nlbutts/POVDisplay/Mechanical/POVBaseDriver.FCStd

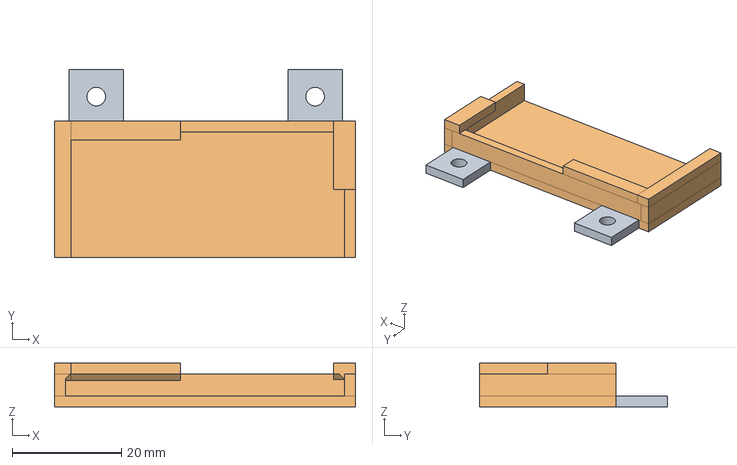
[picture p1: CAD file, 2018-04-08]
Mechanical/POVBaseDriver.FCStd
55.0 x 34.4 x 8.00 mm
