nlbutts/POVDisplay/Mechanical/PCBMotorMount.FCStd

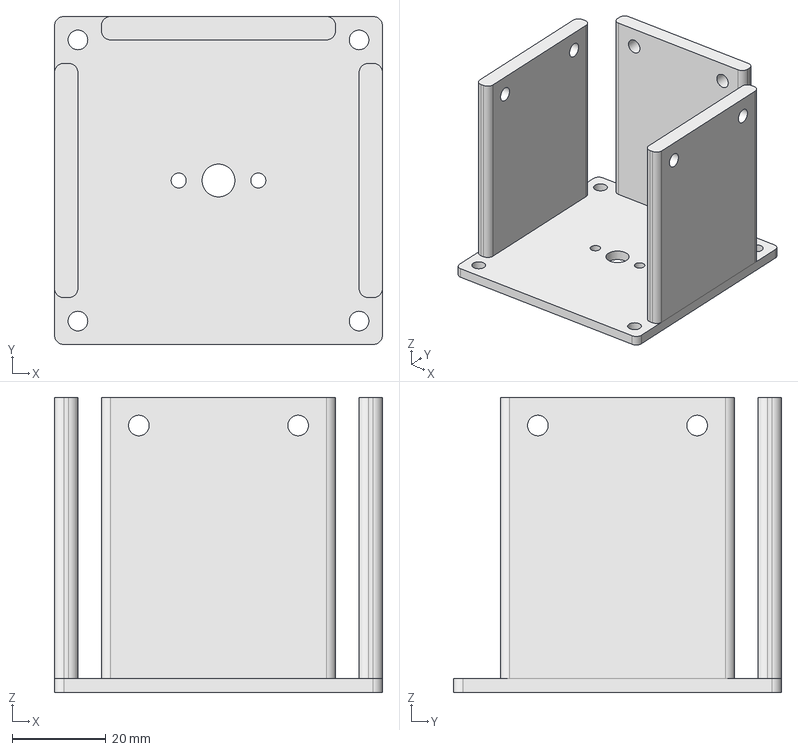
[picture p2: CAD file, 2018-04-08]
Mechanical/PCBMotorMount.FCStd
70.0 x 70.0 x 63.0 mm
