nlbutts/POVDisplay/Mechanical/BalanceSlider.FCStd

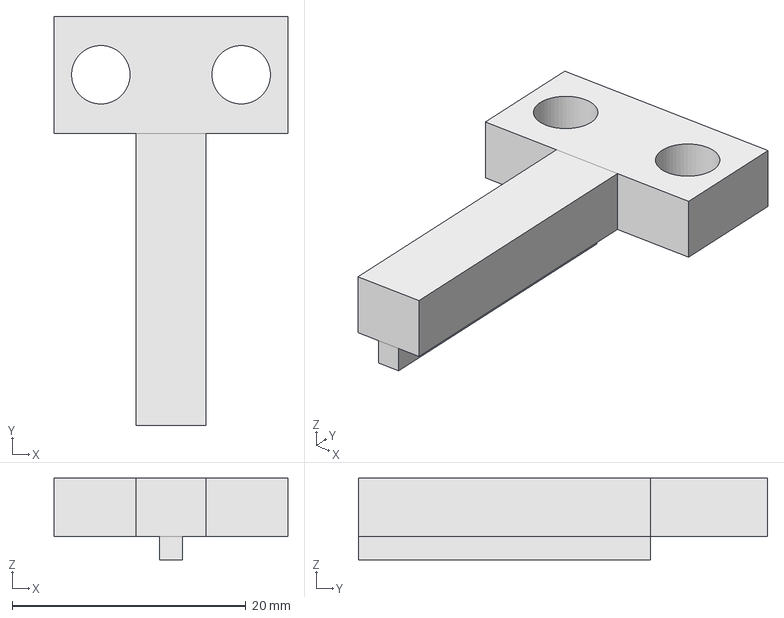
[picture p3: CAD file, 2018-04-08]
Mechanical/BalanceSlider.FCStd
20.0 x 35.0 x 7.00 mm
