nlbutts/POVDisplay/Mechanical/motor_adapter.FCStd

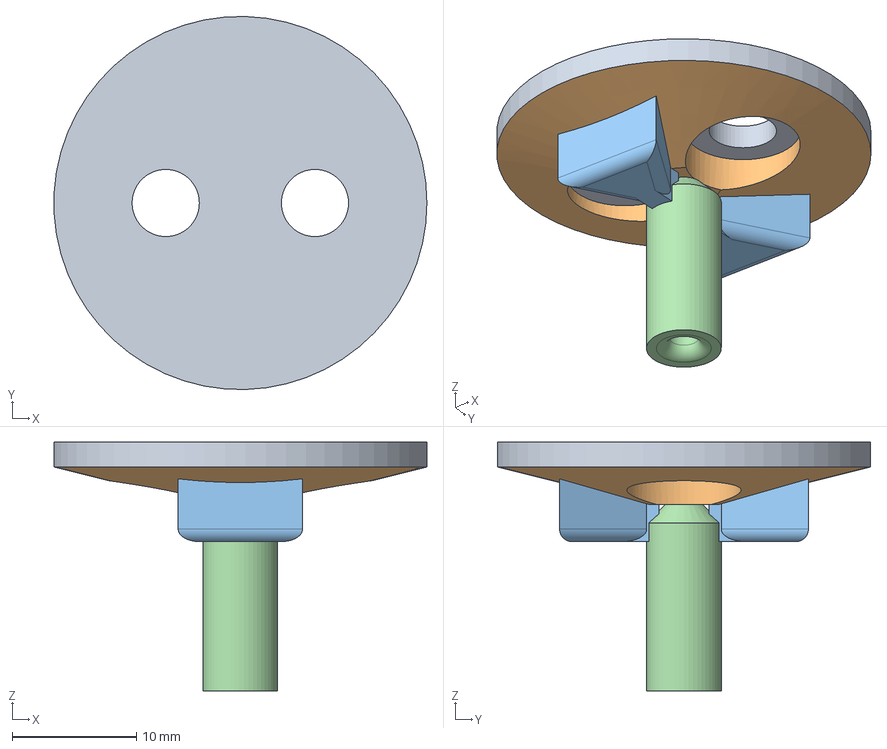
[picture p4: CAD file, 2018-04-08]
Mechanical/motor_adapter.FCStd
30.0 x 30.0 x 20.0 mm
PCBMount
