nlbutts/POVDisplay/Mechanical/WoodMounts.FCStd

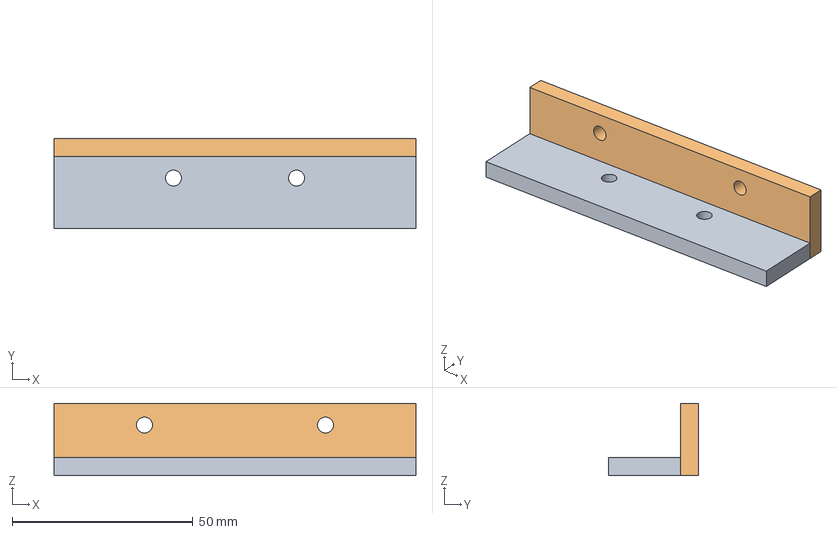
[picture p5: CAD file, 2018-04-08]
Mechanical/WoodMounts.FCStd
100.0 x 25.0 x 20.0 mm
