nlbutts/POVDisplay/Mechanical/PCBMount.FCStd

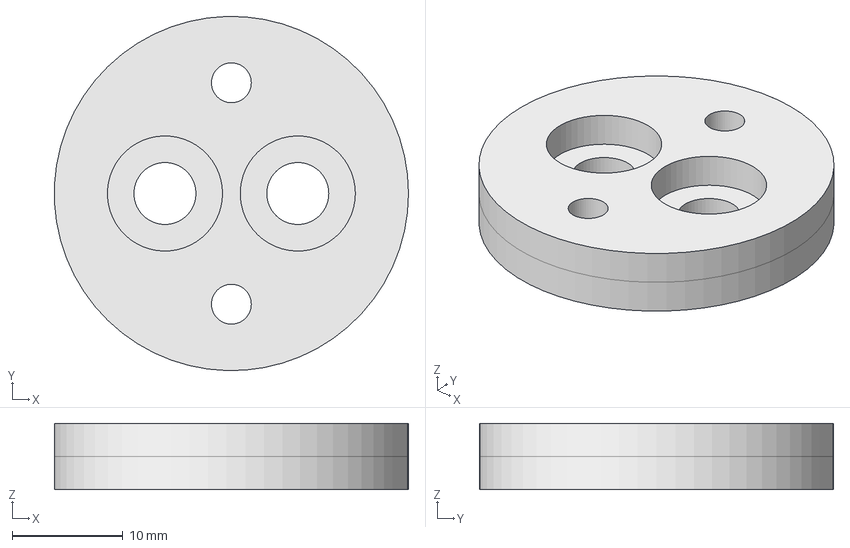
[picture p6: CAD file, 2018-04-08]
Mechanical/PCBMount.FCStd
32.0 x 32.0 x 6.00 mm
