nlbutts/POVDisplay/Mechanical/BalanceWeight.FCStd

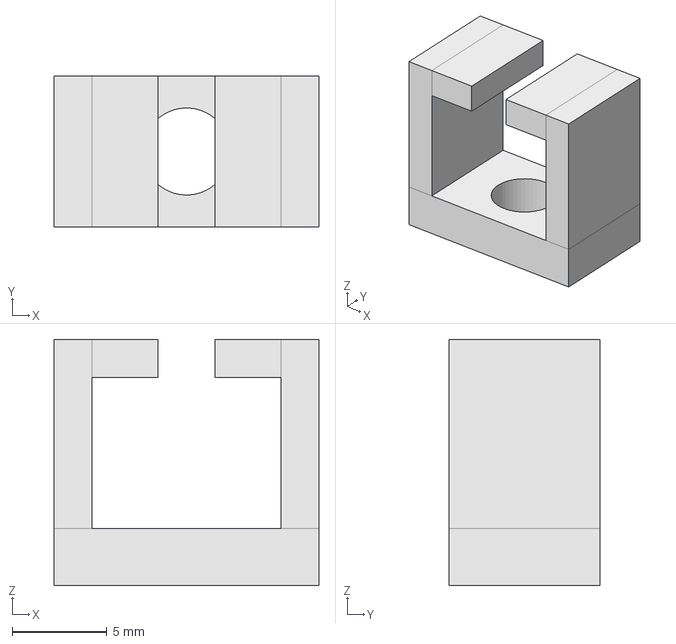
[picture p7: CAD file, 2018-04-08]
Mechanical/BalanceWeight.FCStd
14.0 x 8.00 x 13.0 mm
