nlbutts/POVDisplay/Mechanical/POVDisplay.FCStd

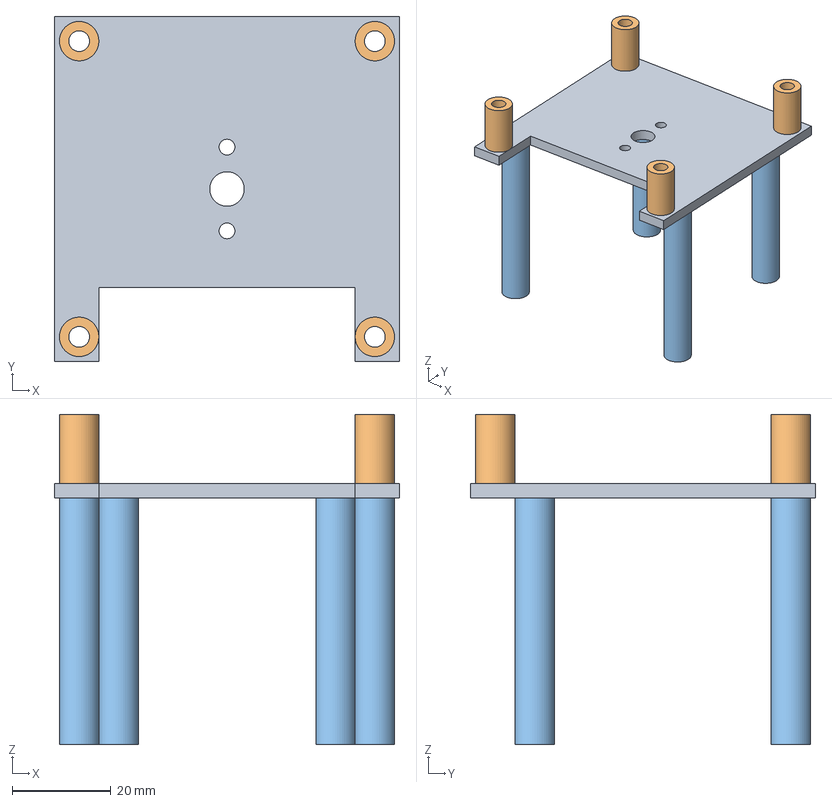
[picture p8: CAD file, 2018-04-08]
Mechanical/POVDisplay.FCStd
70.0 x 70.0 x 67.0 mm
