nlbutts/POVDisplay/Mechanical/TopMotorMount.FCStd

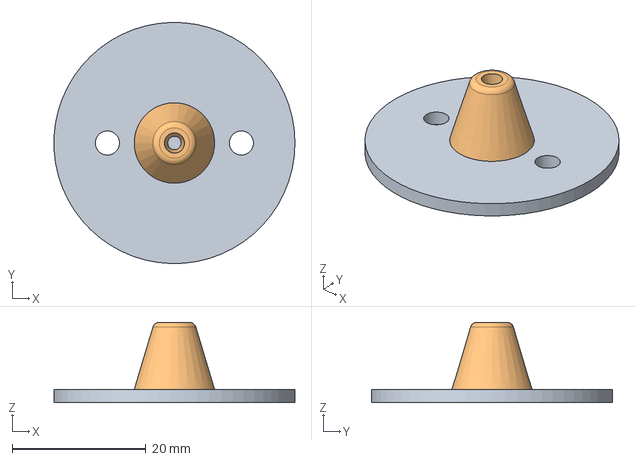
[picture p9: CAD file, 2018-04-08]
Mechanical/TopMotorMount.FCStd
36.0 x 36.0 x 12.0 mm
