nlbutts/POVDisplay/POVRotateHW/POVRotateHW.kicad_pcb

## KiCad design POVRotateHW/POVRotateHW.kicad_pcb (2018-04-08)

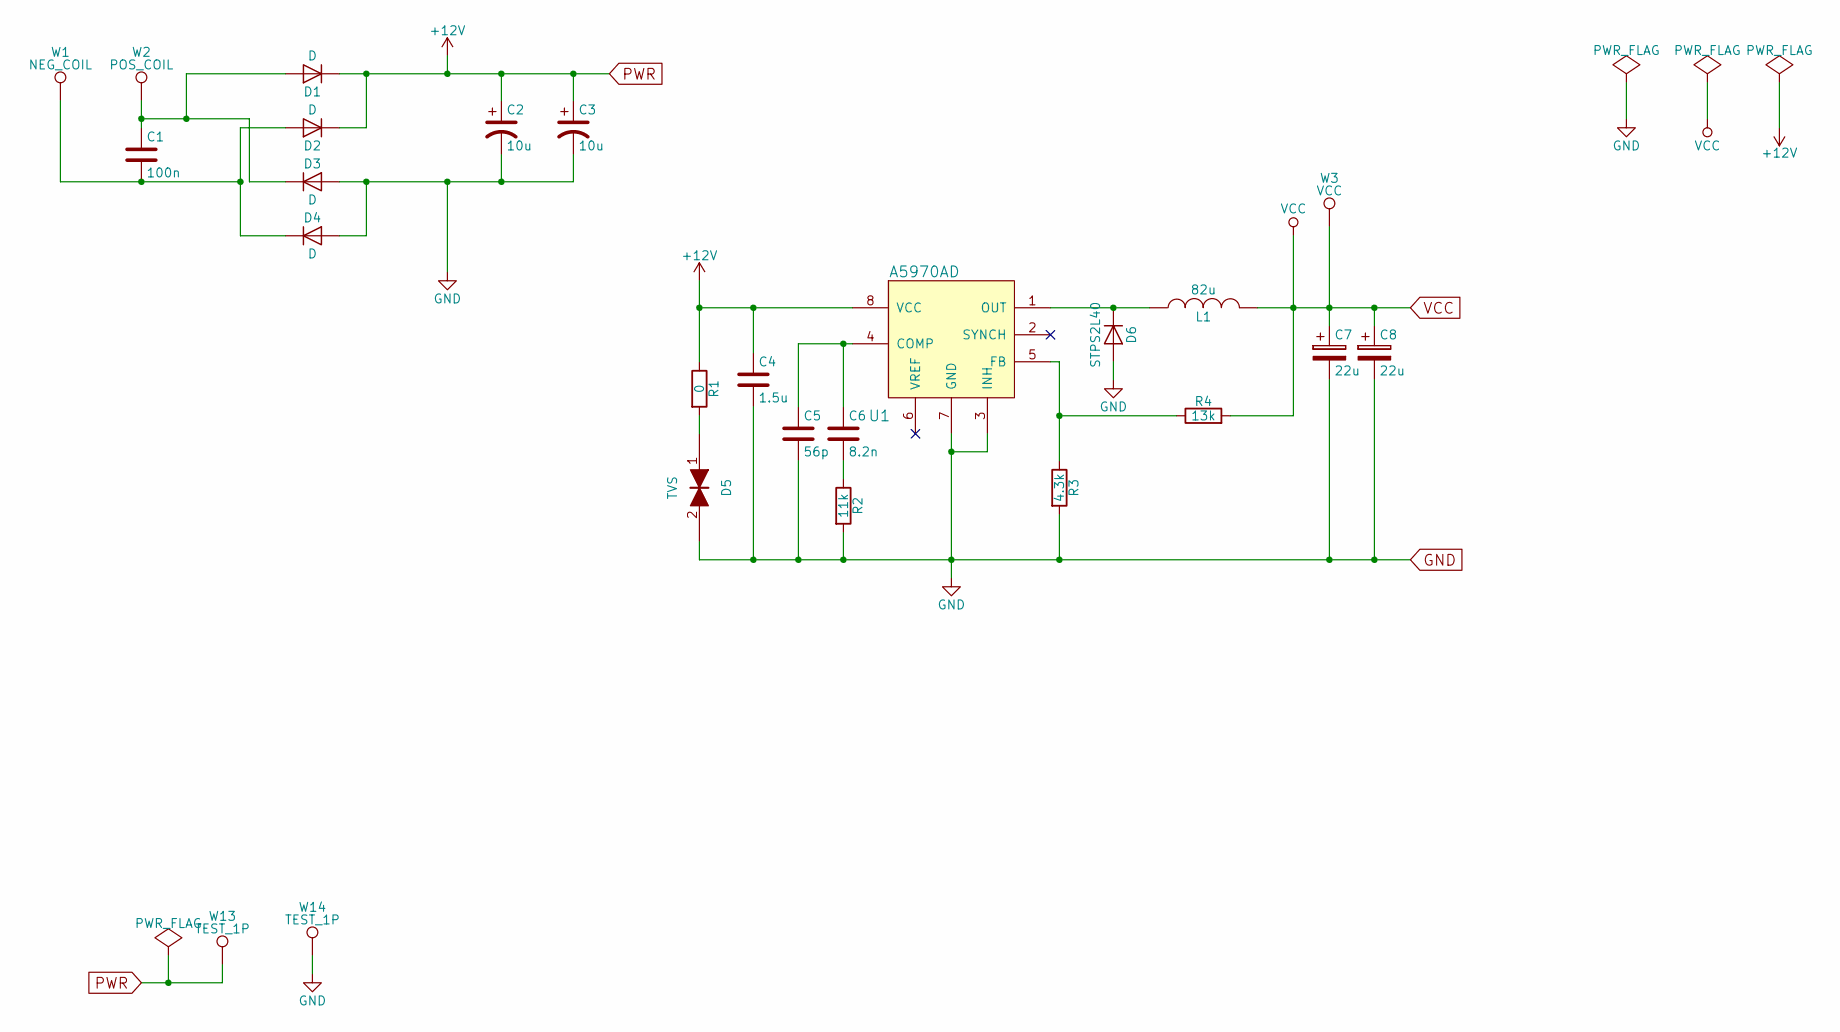
[picture p10: schematic Power.sch, POV Base Controller]

Parts:
C1: 100n; C_1210_HandSoldering
C2, C3: 10u; c_elec_5x5.8; PartNum EEE-FT1H220AR; DIGIKEY PCE5022CT-ND
C4: 1.5u; C_0805_HandSoldering; DIGIKEY 445-12701-1-ND
C5: 56p; C_0603_HandSoldering
C6: 8.2n; C_0603_HandSoldering
C7, C8: 22u; SMD-1210_Pol; PartNum TPSB226K006R0375; DIGIKEY 478-9063-1-ND
D1, D2, D3, D4: D; SMB_Handsoldering; PartNum STPS2L40U; DIGIKEY 497-5574-1-ND
D5: TVS; SMB_Handsoldering; PartNum 824520201; DIGIKEY 732-9779-1-ND
D6: STPS2L40; SMB_Handsoldering; PartNum STPS2L40U; DIGIKEY 497-5574-1-ND
L1: 82u; TDK_inductor_12.95x9.4x8.08; PartNum B82476A1104M; Digikey 495-2686-1-ND
R1: 0; R_0603_HandSoldering
R2: 11k; R_0603_HandSoldering
R3: 4.3k; R_0603_HandSoldering
R4: 13k; R_0603_HandSoldering
U1: A5970AD; SOIC-8-N; PartNum A5970ADTR; DIGIKEY 497-10183-1-ND
W1: NEG_COIL; MountingHole_3.2mm_M3_DIN965_Pad
W2: POS_COIL; MountingHole_3.2mm_M3_DIN965_Pad
W3: VCC; Measurement_Point_Round-SMD-Pad_Small
W13, W14: TEST_1P; Measurement_Point_Round-SMD-Pad_Small

Connections:
GND: C2.2, C3.2, C4.2, C5.2, C7.2, C8.2, D3.2 (A), D4.2 (A), D5.2, D6.2 (A), R2.2, R3.2, U1.3 (INH), U1.7 (GND), W14.1; also elsewhere on the board
unnamed: C1.1, D1.2 (A), D3.1 (K), W2.1
unnamed: C1.2, D2.2 (A), D4.1 (K), W1.1
unnamed: C5.1, C6.1, U1.4 (COMP)
unnamed: C6.2, R2.1
unnamed: D5.1, R1.2
unnamed: D6.1 (K), L1.1, U1.1 (OUT)
unnamed: R3.1, R4.1, U1.5 (FB)
PWR: C2.1, C3.1, C4.1, D1.1 (K), D2.1 (K), R1.1, U1.8 (VCC), W13.1; also elsewhere on the board
VCC: C7.1, C8.1, L1.2, R4.2, W3.1; also elsewhere on the board

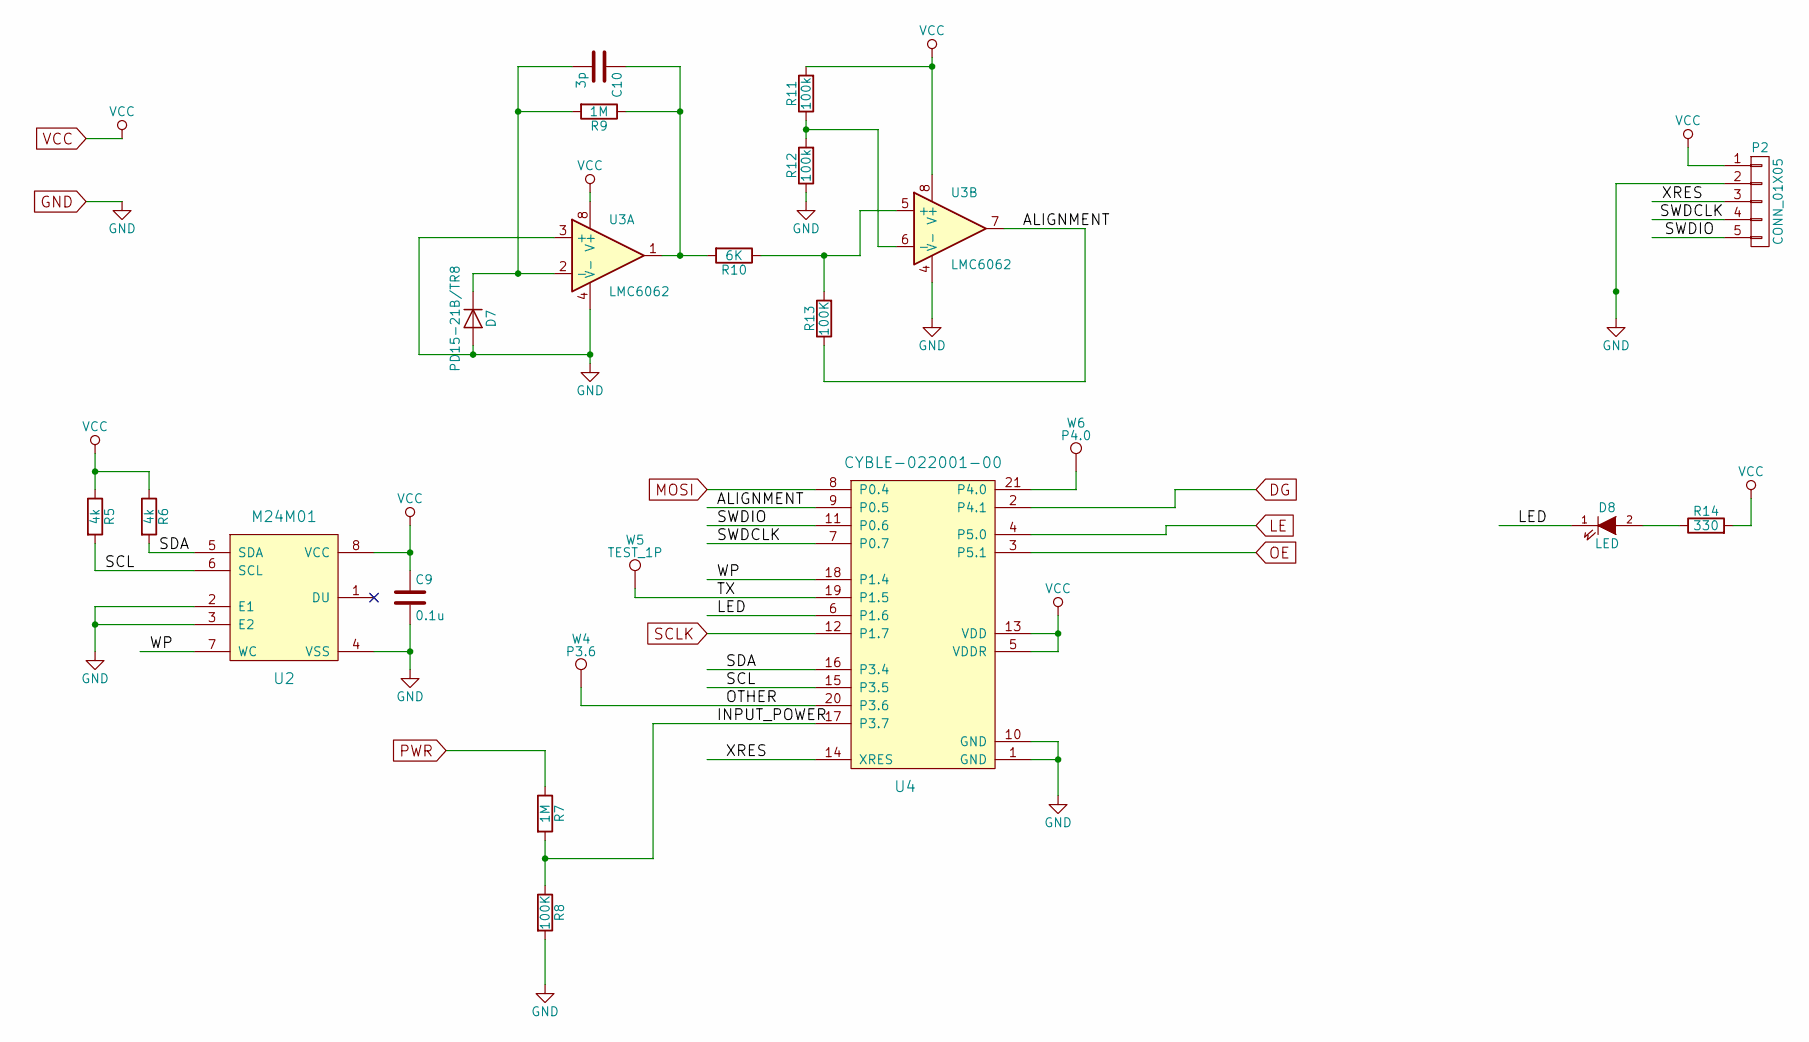
[picture p11: schematic BLE.sch]

Parts:
C9: 0.1u; C_0603_HandSoldering
C10: 3p; C_0603_HandSoldering
D7: PD15-21B/TR8; 2-SMD_Z-Bend; DIGIKEY 475-1346-1-ND
D8: LED; LED_0603; PartNum LG L29K-G2J1-24-Z; Digikey 475-2709-1-ND
P2: CONN_01X05; Socket_Strip_Straight_1x05
R5, R6: 4k; R_0603_HandSoldering
R7, R9: 1M; R_0603_HandSoldering
R8, R13: 100K; R_0603_HandSoldering
R10: 6K; R_0603_HandSoldering
R11, R12: 100k; R_0603_HandSoldering
R14: 330; R_0603_HandSoldering
U2: M24M01; SOIC-8-N; PartNum M24M01-RMN6TP; DIGIKEY 497-6351-1-ND
U3: LMC6062; SOIC-8-N; DIGIKEY LMC6032IMX/NOPBCT-ND
U4: CYBLE-022001-00; CYBLE-022001; PartNum CYBLE-022001-00; DIGIKEY 428-3566-PROMO-ND
W4: P3.6; Measurement_Point_Round-SMD-Pad_Small
W5: TEST_1P; Measurement_Point_Round-SMD-Pad_Small
W6: P4.0; Measurement_Point_Round-SMD-Pad_Small

Connections:
/BLE/ALIGNMENT: R13.1, U3.7, U4.9 (P0.5)
/BLE/INPUT_POWER: R7.2, R8.1, U4.17 (P3.7)
/BLE/LED: D8.1 (K), U4.6 (P1.6)
/BLE/OTHER: U4.20 (P3.6), W4.1
/BLE/SCL: R5.2, U2.6 (SCL), U4.15 (P3.5)
/BLE/SDA: R6.2, U2.5 (SDA), U4.16 (P3.4)
/BLE/SWDCLK: P2.4, U4.7 (P0.7)
/BLE/SWDIO: P2.5, U4.11 (P0.6)
/BLE/TX: U4.19 (P1.5), W5.1
/BLE/WP: U2.7 (WC), U4.18 (P1.4)
/BLE/XRES: P2.3, U4.14 (XRES)
DG: U4.2 (P4.1); also elsewhere on the board
GND: C9.2, D7.2 (A), P2.2, R8.2, R12.1, U2.2 (E1), U2.3 (E2), U2.4 (VSS), U3.3 (+), U3.4 (V-), U4.1 (GND), U4.10 (GND); also elsewhere on the board
LE: U4.4 (P5.0); also elsewhere on the board
MOSI: U4.8 (P0.4); also elsewhere on the board
unnamed: C10.1, R9.1, R10.2, U3.1
unnamed: C10.2, D7.1 (K), R9.2, U3.2 (-)
unnamed: D8.2 (A), R14.1
unnamed: R10.1, R13.2, U3.5 (+)
unnamed: R11.1, R12.2, U3.6 (-)
unnamed: U4.21 (P4.0), W6.1
OE: U4.3 (P5.1); also elsewhere on the board
PWR: R7.1; also elsewhere on the board
SCLK: U4.12 (P1.7); also elsewhere on the board
VCC: C9.1, P2.1, R5.1, R6.1, R11.2, R14.2, U2.8 (VCC), U3.8 (V+), U4.5 (VDDR), U4.13 (VDD); also elsewhere on the board

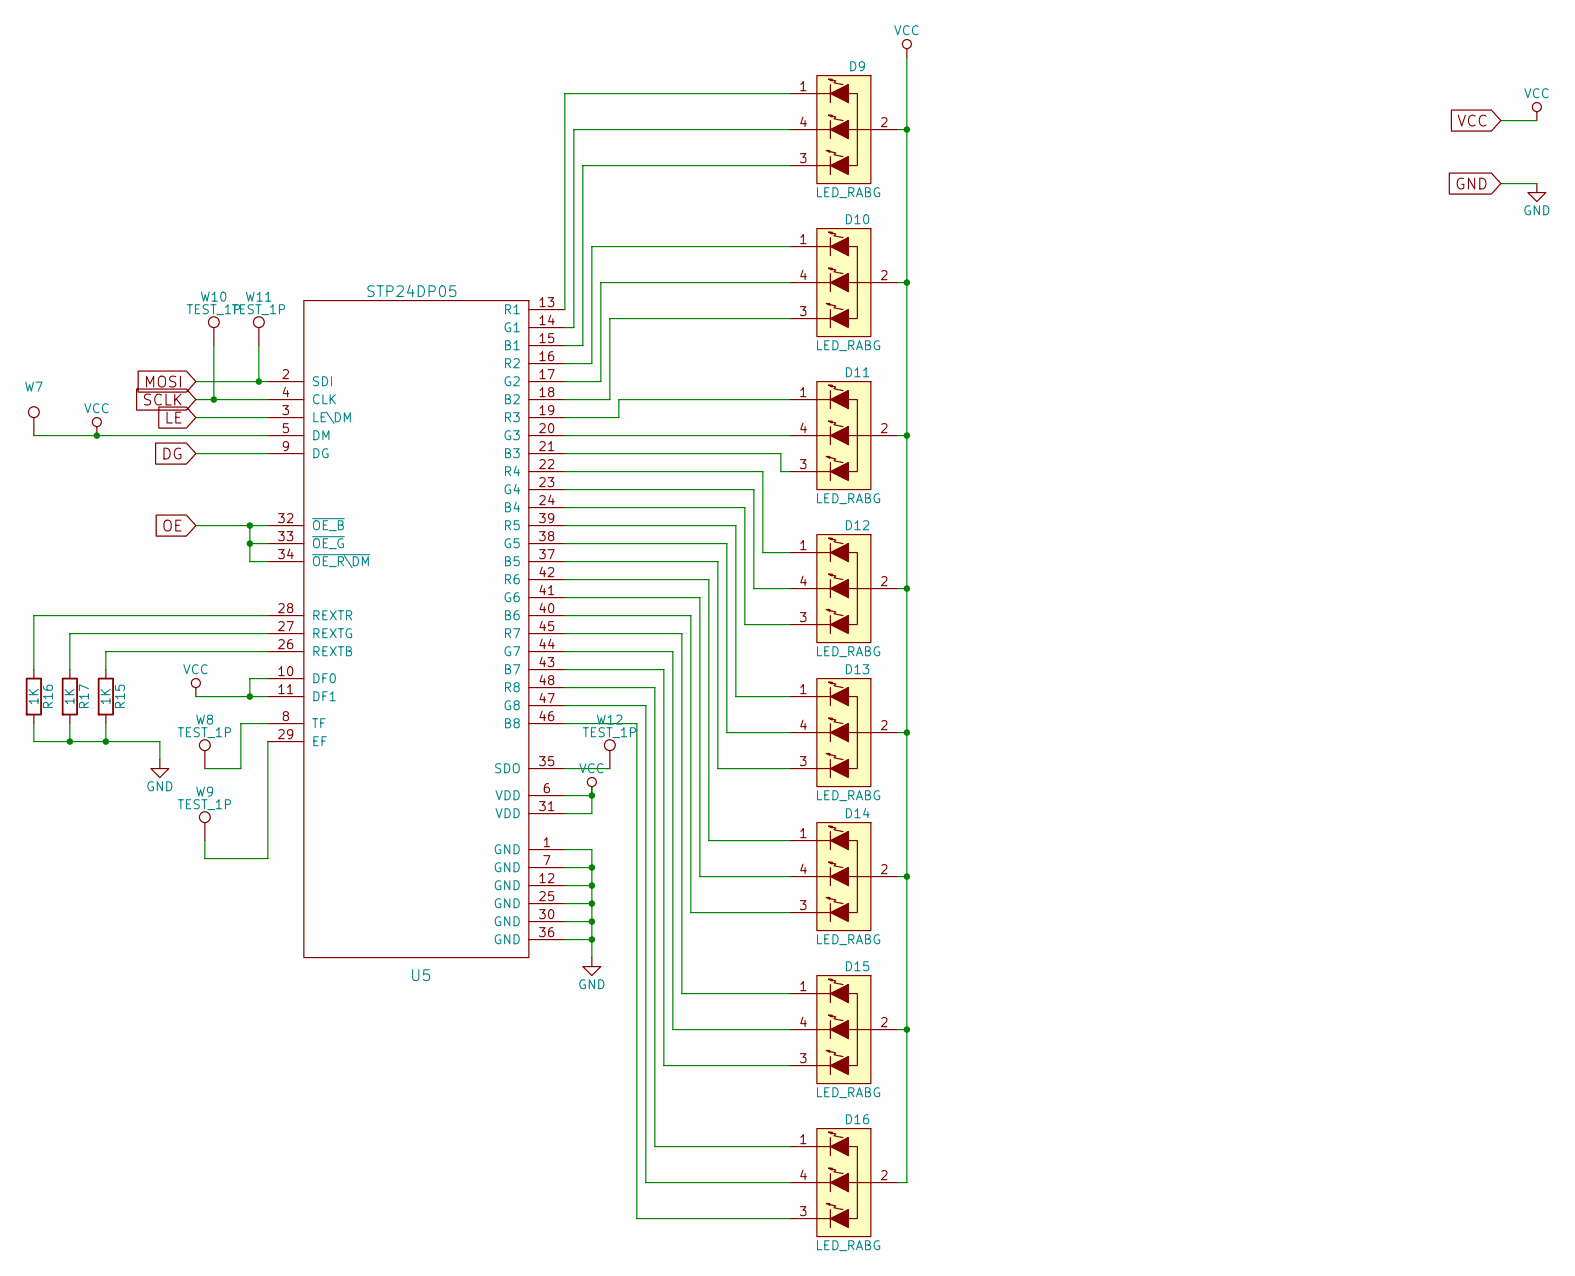
[picture p12: schematic LEDs.sch]

Parts:
D9: LED_RABG; CREE_PLCC4; PartNum CLV1A-FKB-CHMKPEHBB7A363; DIGIKEY CLV1A-FKB-CHMKPEHBB7A363CT-ND
D10, D11, D12, D13, D14, D15, D16: LED_RABG; CREE_PLCC4
R15, R16, R17: 1K; R_0805
U5: STP24DP05; TQFP-48_7x7mm_Pitch0.5mm; PartNum STP24DP05BTR; DIGIKEY 497-8283-1-ND
W7, W8, W9, W10, W11, W12: TEST_1P; Measurement_Point_Round-SMD-Pad_Small

Connections:
DG: U5.9 (DG); also elsewhere on the board
GND: R15.2, R16.2, R17.2, U5.1 (GND), U5.7 (GND), U5.12 (GND), U5.25 (GND), U5.30 (GND), U5.36 (GND); also elsewhere on the board
LE: U5.3 (LE\DM); also elsewhere on the board
MOSI: U5.2 (SDI), W11.1; also elsewhere on the board
unnamed: D9.1 (RED_CATHODE), U5.13 (R1)
unnamed: D9.3 (BLUE_CATHODE), U5.15 (B1)
unnamed: D9.4 (GREEN_CATHODE), U5.14 (G1)
unnamed: D10.1 (RED_CATHODE), U5.16 (R2)
unnamed: D10.3 (BLUE_CATHODE), U5.18 (B2)
unnamed: D10.4 (GREEN_CATHODE), U5.17 (G2)
unnamed: D11.1 (RED_CATHODE), U5.19 (R3)
unnamed: D11.3 (BLUE_CATHODE), U5.21 (B3)
unnamed: D11.4 (GREEN_CATHODE), U5.20 (G3)
unnamed: D12.1 (RED_CATHODE), U5.22 (R4)
unnamed: D12.3 (BLUE_CATHODE), U5.24 (B4)
unnamed: D12.4 (GREEN_CATHODE), U5.23 (G4)
unnamed: D13.1 (RED_CATHODE), U5.39 (R5)
unnamed: D13.3 (BLUE_CATHODE), U5.37 (B5)
unnamed: D13.4 (GREEN_CATHODE), U5.38 (G5)
unnamed: D14.1 (RED_CATHODE), U5.42 (R6)
unnamed: D14.3 (BLUE_CATHODE), U5.40 (B6)
unnamed: D14.4 (GREEN_CATHODE), U5.41 (G6)
unnamed: D15.1 (RED_CATHODE), U5.45 (R7)
unnamed: D15.3 (BLUE_CATHODE), U5.43 (B7)
unnamed: D15.4 (GREEN_CATHODE), U5.44 (G7)
unnamed: D16.1 (RED_CATHODE), U5.48 (R8)
unnamed: D16.3 (BLUE_CATHODE), U5.46 (B8)
unnamed: D16.4 (GREEN_CATHODE), U5.47 (G8)
unnamed: R15.1, U5.26 (REXTB)
unnamed: R16.1, U5.28 (REXTR)
unnamed: R17.1, U5.27 (REXTG)
unnamed: U5.8 (TF), W8.1
unnamed: U5.29 (EF), W9.1
unnamed: U5.35 (SDO), W12.1
OE: U5.32 (~OE_B), U5.33 (~OE_G), U5.34 (~OE_R\DM); also elsewhere on the board
SCLK: U5.4 (CLK), W10.1; also elsewhere on the board
VCC: D9.2 (COMMON_ANODE), D10.2 (COMMON_ANODE), D11.2 (COMMON_ANODE), D12.2 (COMMON_ANODE), D13.2 (COMMON_ANODE), D14.2 (COMMON_ANODE), D15.2 (COMMON_ANODE), D16.2 (COMMON_ANODE), U5.5 (DM), U5.6 (VDD), U5.10 (DF0), U5.11 (DF1), U5.31 (VDD), W7.1; also elsewhere on the board

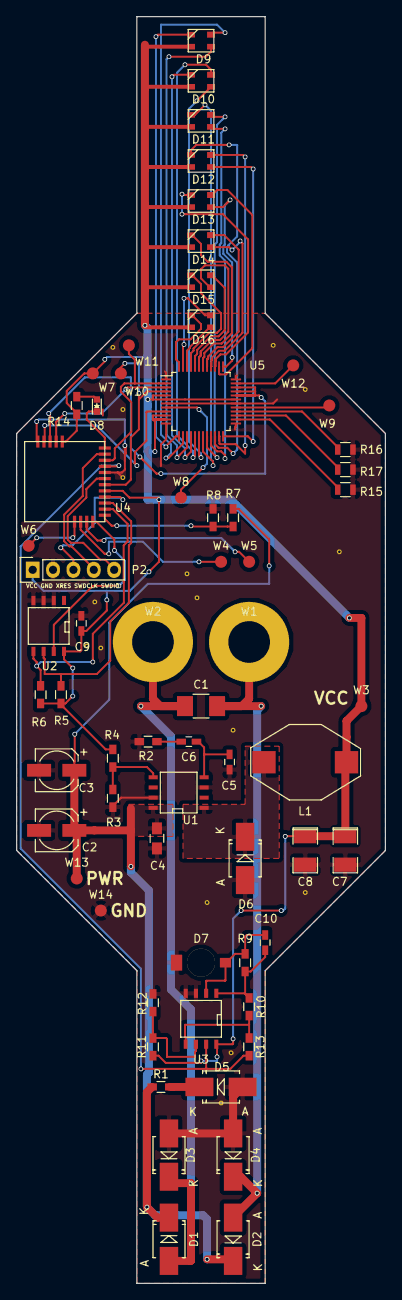
[picture p13: board POVRotateHW.kicad_pcb from above]

Board: 2 copper layers, 46.0 x 158.0 mm, 64 parts (0 on the bottom side), 62 nets.
