nlbutts/POVDisplay/POVBaseCoil/POVBaseCoil.kicad_pcb

## KiCad design POVBaseCoil/POVBaseCoil.kicad_pcb (2018-04-08)

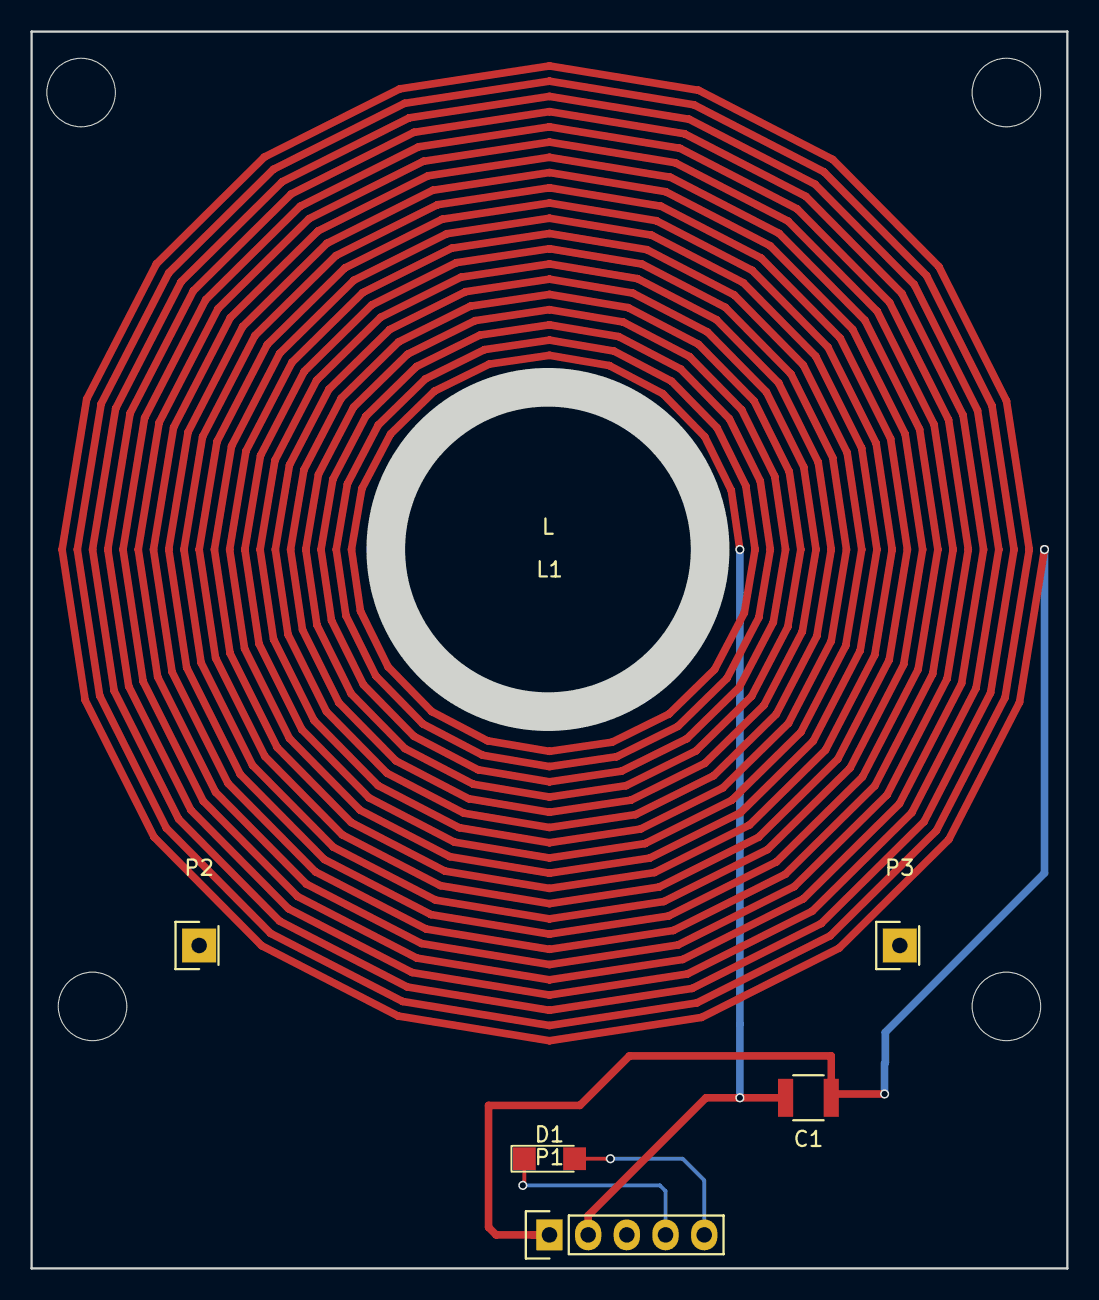
[picture p14: board POVBaseCoil.kicad_pcb from above]

Board: 2 copper layers, 68.0 x 81.2 mm, 6 parts (0 on the bottom side), 4 nets.

Parts:
C1: C; C_1210
D1: LED; LED_1206
L1: L; pov_coil
P1: CONN_01X05; Socket_Strip_Straight_1x05
P2, P3: CONN_01X01; Socket_Strip_Straight_1x01

Connections:
unnamed: C1.1, L1.1, P1.1
unnamed: C1.2, L1.2, P1.2
unnamed: D1.1, P1.4
unnamed: D1.2, P1.5
