nlbutts/POVDisplay/POVBaseController/POVBaseController.kicad_pcb

## KiCad design POVBaseController/POVBaseController.kicad_pcb (2018-04-08)

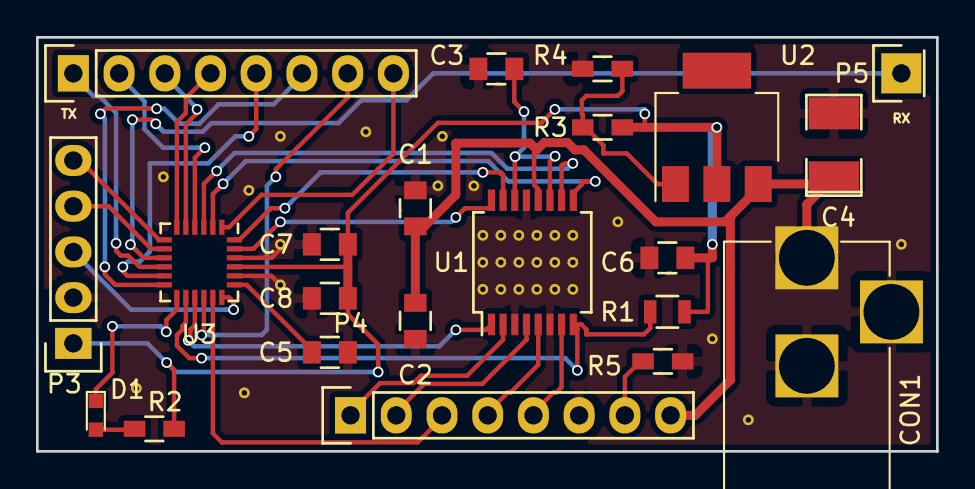
[picture p15: board POVBaseController.kicad_pcb from above]

Board: 2 copper layers, 50.0 x 23.0 mm, 22 parts (0 on the bottom side), 32 nets.

Parts:
C1, C5, C8: 0.1u; C_0805
C2: 10u; C_0805
C3: 2.2u; C_0805
C4: 10u; SMD-1210_Pol
C6, C7: 1u; C_0805
CON1: BARREL_JACK
D1: LED; LED_0603
P2, P4: CONN_01X08; Socket_Strip_Straight_1x08
P3: CONN_01X05; Socket_Strip_Straight_1x05
P5: CONN_01X01; Socket_Strip_Straight_1x01
R1: 10K; R_0805
R2: 330; R_0603_HandSoldering
R3: 120; R_0603_HandSoldering
R4: 360; R_0603_HandSoldering
R5: 1.5k; R_0603_HandSoldering
U1: DRV8848; SSOP-16_5.3x6.2mm_Pitch0.65mm
U2: LM317AEMP; SOT-223
U3: CY8C4024LQI-S401; QFN-24_4x4mm_Pitch0.5mm

Connections:
+12V: C1.2, C2.2, C4.1, CON1.1, P4.8, U1.12, U2.3
/COIL_IN_A: U1.9, U3.2
/COIL_IN_B: U1.10, U3.3
/COIL_OUT_A: P4.5, U1.7
/COIL_OUT_B: P4.4, U1.5
/LED: D1.1, U3.13
/MOTOR_IN_A: U1.16, U3.23
/MOTOR_IN_B: U1.15, U3.24
/MOTOR_OUT_A: P4.1, U1.2
/MOTOR_OUT_B: P4.2, U1.4
/NIR_EMITTER: P4.7, R5.1
/SPARE_1: P2.2, U3.4
/SPARE_2: P2.3, U3.5
/SPARE_3: P2.4, U3.6
/SPARE_4: P2.5, U3.11
/SPARE_5: P2.6, U3.12
/SPARE_6: P2.7, U3.16
/SPARE_7: P2.8, U3.1
/SPARE_8: P4.3, U3.17
/SWDCLK: P3.4, U3.8
/SWDIO: P3.5, U3.7
/UART_RX: P5.1, U3.9
/UART_TX: P2.1, U3.10
/XRES: P3.3, U3.18
/nFAULT: R1.2, U1.8, U3.14
/nSLEEP: U1.1, U3.15
GND: C1.1, C2.1, C3.1, C4.2, C5.2, C6.2, C7.2, C8.2, CON1.2, CON1.3, P3.2, P4.6, R4.2, R5.2, U1.3, U1.6, U1.13, U3.20, U3.22
unnamed: C3.2, U1.11, U1.14
unnamed: C5.1, U3.19
unnamed: D1.2, R2.1
unnamed: R3.2, R4.1, U2.1
VCC: C6.1, C7.1, C8.1, P3.1, R1.1, R2.2, R3.1, U2.2, U3.21
