nlbutts/POVDisplay/POVRotate.cydsn/main.c

/* ========================================
 *
 * Copyright YOUR COMPANY, THE YEAR
 * All Rights Reserved
 * UNPUBLISHED, LICENSED SOFTWARE.
 *
 * CONFIDENTIAL AND PROPRIETARY INFORMATION
 * WHICH IS THE PROPERTY OF your company.
 *
 * ========================================
*/
#include <stdio.h>
#include <project.h>
#include "LED.h"
#include "EEPROM.h"
#include "app_Ble.h"
#include "app_LED.h"
#include "uartBuf.h"
#include "stdbool.h"
#include "options.h"
#include "fonts.h"

#define UPDATES_PER_ROTATION    120
#define SECONDS_TO_UPDATES(x)   ((x * UPDATES_PER_ROTATION) / 60)

/* Holds the input power in millivolts */
static uint32_t _pwrMVolts;

/* The previous rising edge of photodiode output */
static uint16_t _previousCapture = 0;

/* The output of the filtered rotation value */
uint32_t _rotationFilterGain = 0.1 * 256;
int32_t _rotationRate = 0;

/* LED State of the 4 quad display */
static uint8_t  _ledState = 0;
static uint32_t _angle = 0;

/* The local LED states */
static uint8_t  _leds[3] = {0};

/* Holds a 60 second free running counter */
uint32_t _timeInSeconds = 0;

/* Debug variables for counting interrupts */
static uint32_t _alignmentIntCount = 0;
static uint32_t _ledUpdateIntCount = 0;
static uint8_t  _hoursInClockPos;
static uint8_t  _minutesInClockPos;


/* Holds the filter for the task time */
static int32_t _drawLoopAvg = 0;
#define UPDATE_FILTER_GAIN      (0.1 * 256)

/* Used to hold a user settable draw offset in the degrees */
uint16_t _drawOffset;

uint8_t _sendUpdate = 0;

char printStr[10];

uint32_t getAngle()
{
    return _angle % 360;
}

void generateQuadPattern()
{
    if (_ledState < 15)
    {
        _leds[0] = 0xFF;
        _leds[1] = 0;
        _leds[2] = 0;
        led_pushLEDs(_leds);
    }
    else if (_ledState < 30)
    {
        _leds[0] = 0;
        _leds[1] = 0xFF;
        _leds[2] = 0;
        led_pushLEDs(_leds);
    }
    else if (_ledState < 45)
    {
        _leds[0] = 0;
        _leds[1] = 0;
        _leds[2] = 0xFF;
        led_pushLEDs(_leds);
    }
    else if (_ledState < 60)
    {
        _leds[0] = 0xFF;
        _leds[1] = 0xFF;
        _leds[2] = 0xFF;
        led_pushLEDs(_leds);
    }
    else
    {
        _leds[0] = 0;
        _leds[1] = 0;
        _leds[2] = 0;
        led_pushLEDs(_leds);
    }
    _ledUpdateIntCount++;
    _ledState++;
    if (_ledState >= UPDATES_PER_ROTATION)
    {
        _ledState = 0;
    }
}

void printText()
{
    uint32_t strLen = strlen(printStr);
    uint32_t angle = getAngle();
    uint32_t cIndex = angle >> 5;
    uint32_t bIndex = angle & 0x1F;
    bIndex /= 4;
    if (cIndex < strLen)
    {
        char c = printStr[cIndex];
        const uint8_t * ptr = &Font12.table[(c - ' ') * Font12.Height];

        if (bIndex < 7)
        {
            uint8_t mask = 0x80 >> bIndex;
            uint8_t shift1 = 7 - bIndex;
            uint8_t shift2 = 7;
            uint8_t temp = 0;
            temp |= ((ptr[8] & mask) >> shift1) << shift2--;
            temp |= ((ptr[7] & mask) >> shift1) << shift2--;
            temp |= ((ptr[6] & mask) >> shift1) << shift2--;
            temp |= ((ptr[5] & mask) >> shift1) << shift2--;
            temp |= ((ptr[4] & mask) >> shift1) << shift2--;
            temp |= ((ptr[3] & mask) >> shift1) << shift2--;
            temp |= ((ptr[2] & mask) >> shift1) << shift2--;
            temp |= ((ptr[1] & mask) >> shift1) << shift2--;

            _leds[0] = temp;
            _leds[1] = 0;
            _leds[2] = 0;
        }
        else
        {
            _leds[0] = 0;
            _leds[1] = 0;
            _leds[2] = 0;
        }
    }
    else
    {
        _leds[0] = 0;
        _leds[1] = 0;
        _leds[2] = 0;
    }
}

void generateClock()
{
    int temp = SECONDS_TO_UPDATES(_timeInSeconds) - _ledState;
    if ((temp > 0) && (temp <= 2))
    {
        // If within 5 seconds, draw red
        _leds[0] = 0xFF;
        _leds[1] = 0;
        _leds[2] = 0;
    }
    else if ((temp > 0) && (temp <= 4))
    {
        // Draw green
        _leds[0] = 0x3F;
        _leds[1] = 0;
        _leds[2] = 0;
    }
    else if ((temp > 0) && (temp <= 6))
    {
        // Draw green
        _leds[0] = 0x0F;
        _leds[1] = 0;
        _leds[2] = 0;
    }
    else if ((temp > 0) && (temp <= 8))
    {
        // Draw green
        _leds[0] = 0x03;
        _leds[1] = 0;
        _leds[2] = 0;
    }
    else
    {
        // Make dark
        _leds[0] = 0;
        _leds[1] = 0;
        _leds[2] = 0;
    }

    if ((_ledState == SECONDS_TO_UPDATES(15)) ||
        (_ledState == SECONDS_TO_UPDATES(30)) ||
        (_ledState == SECONDS_TO_UPDATES(45)) ||
        (_ledState == SECONDS_TO_UPDATES(0)))
    {
        _leds[0] |= 0x01;
        _leds[1] |= 0x01;
        _leds[2] |= 0x01;
    }
    
    if (SECONDS_TO_UPDATES(_hoursInClockPos) == _ledState)
    {
        _leds[0] |= 0;
        _leds[1] |= 0xFC;
        _leds[2] |= 0;        
    }

    if (SECONDS_TO_UPDATES(_minutesInClockPos) == _ledState)
    {
        _leds[0] |= 0;
        _leds[1] |= 0;
        _leds[2] |= 0xFF;        
    }

    _ledState++;
    if (_ledState >= UPDATES_PER_ROTATION)
    {
        _ledState = 0;
    }    
}

int32_t filter(int32_t x, int32_t y, int32_t k)
{
    y = y + ((((x - y) * k) + (1 << 4)) >> 8);
    return y;
}

CY_ISR(adcISR)
{
    uint16_t result = ADC_SAR_Seq_GetResult16(1);
    _pwrMVolts = result;
    _pwrMVolts = ADC_SAR_Seq_CountsTo_mVolts(1, result);
    _pwrMVolts *= 11;
}

CY_ISR(alignmentISR)
{
    TimerAlignment_ClearInterrupt(0xFF);
    uint16_t capture = TimerAlignment_ReadCapture();
    uint16_t diffTime = capture - _previousCapture;
    _previousCapture = capture;
    _rotationRate = filter(diffTime, _rotationRate, _rotationFilterGain);
    if (_rotationRate < MINIMUM_ROTATION_RATE)
    {
        TimerLED_Stop();
    }
    else
    {
        TimerLED_Start();
        TimerLED_WritePeriod(_rotationRate/UPDATES_PER_ROTATION);
        TimerLED_WriteCounter(0);
    }
    _ledState = _drawOffset;
    _angle = _drawOffset;
    _alignmentIntCount++;
}

CY_ISR(ledUpdateISR)
{
    uint16_t start = TimeSpan_ReadCounter();
    TimerLED_ClearInterrupt(TimerLED_INTR_MASK_CC_MATCH | TimerLED_INTR_MASK_TC);

    _angle += 360 / UPDATES_PER_ROTATION;
    
    //printText();
    generateClock();

    led_pushLEDs(_leds);

    uint16_t stop = TimeSpan_ReadCounter();
    _drawLoopAvg = filter(stop - start, _drawLoopAvg, UPDATE_FILTER_GAIN);
}

static uint32_t _oneSecondCounter = 0;
static uint8_t  _displayTime = 0;
void sysTickCallback(void)
{
    _oneSecondCounter++;
    if (_oneSecondCounter >= 1000)
    {
        _sendUpdate++;
        _oneSecondCounter = 0;
        _timeInSeconds++;
        if (_timeInSeconds >= 60)
        {
            _timeInSeconds = 0;
        }

        //RTC_Update();
        if (_displayTime < 10)
        {
            uint32_t time = RTC_GetTime();
            //snprintf(printStr, 10, "%02d:%02d:%02d", (int)RTC_GetHours(time), (int)RTC_GetMinutes(time), (int)RTC_GetSecond(time));
            _hoursInClockPos    = RTC_GetHours(time);
            if (_hoursInClockPos > 12)
            {
                _hoursInClockPos -= 12;
            }
            _hoursInClockPos *= 5;
            _minutesInClockPos  = RTC_GetMinutes(time);
        }
        else if (_displayTime < 20)
        {
            uint32_t date = RTC_GetDate();
            //snprintf(printStr, 10, "%02d/%02d/%02d", (int)RTC_GetMonth(date), (int)RTC_GetDay(date), (int)RTC_GetYear(date) - 2000);
        }
        else
        {
            _displayTime = 0;
        }
        _displayTime++;
        
        updateRotationRate(_rotationRate);
        updateVoltage(_pwrMVolts);
        updateDrawLoopAverage(_drawLoopAvg);
    }
}

int main()
{
    CyGlobalIntEnable; /* Enable global interrupts. */

    /* Start UART and BLE component and display project information */
    const uint8_t swVersion[3] = {1, 0, 0};
    bleAppInit(swVersion);

    CyBle_ProcessEvents();


    /* Place your initialization/startup code here (e.g. MyInst_Start()) */
    SPI_LED_Start();
    I2C_EEPROM_Start();

    // Configure the LED code.
    LED_S cfg;
    cfg.numberOfLeds = 8;
    led_init(&cfg);

    // Configure the EEPROM
    struct I2CInterface i2cCfg;
    i2cCfg.write        = I2C_EEPROM_I2CMasterWriteBuf;
    i2cCfg.read         = I2C_EEPROM_I2CMasterReadBuf;
    i2cCfg.getStatus    = I2C_EEPROM_I2CMasterStatus;
    i2cCfg.delayUs      = CyDelayUs;
    i2cCfg.clearStatus  = I2C_EEPROM_I2CMasterClearStatus;

    i2cCfg.transferInProgressMask   = I2C_EEPROM_I2C_MSTAT_XFER_INP;
    i2cCfg.errorMask                = I2C_EEPROM_I2C_MSTAT_ERR_XFER;
    i2cCfg.completeTransferMask     = I2C_EEPROM_I2C_MODE_COMPLETE_XFER;
    i2cCfg.deviceAddress            = 0x50;
    EEPROM_init_i2c(i2cCfg);

    isrADC_StartEx(adcISR);

    ADC_SAR_Seq_Start();
    ADC_SAR_Seq_StartConvert();

    TimerAlignment_Start();
    alignment_isr_StartEx(alignmentISR);

    isrLEDUpdate_StartEx(ledUpdateISR);

    CySysTickStart();
    CySysTickSetCallback(0, sysTickCallback);

    TimeSpan_Start();

    RTC_Start();

    uint32_t date = RTC_ConstructDate(2, 1, 2017);
    uint32_t time = RTC_ConstructTime(RTC_24_HOURS_FORMAT, 0, 20, 41, 00);
    RTC_SetDateAndTime(time, date);

    WP_Write(0);

    DisUpdateFirmWareRevision();
    DisUpdateSoftWareRevision(1, 1, 0, 123);

    for(;;)
    {
        //printHello();
        HandleLeds();
        CyBle_ProcessEvents();
        
//        if (_sendUpdate == 2)
//        {
//            _sendUpdate = 0;
//            printf("Main power %d mV\n", (int)_pwrMVolts);
//            _pwrMVolts = 0;
//            printf("Rotation rate %d in us\n", (int)_rotationRate * 10);
//            printf("Loop average %d in us\n", (int)_drawLoopAvg);
//        }
    }
}

/* [] END OF FILE */
