nlbutts/POVDisplay/BLE101/app/src/main/java/com/cypress/academy/ble101/PSoCCapSenseLedService.java

/*
Copyright (c) 2016, Cypress Semiconductor Corporation
All rights reserved.

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


For more information on Cypress BLE products visit:
http://www.cypress.com/products/bluetooth-low-energy-ble
 */

package com.cypress.academy.ble101;

import android.annotation.TargetApi;
import android.app.IntentService;
import android.bluetooth.BluetoothGattCharacteristic;
import android.app.Service;
import android.bluetooth.BluetoothAdapter;
import android.bluetooth.BluetoothDevice;
import android.bluetooth.BluetoothGatt;
import android.bluetooth.BluetoothGattCallback;
import android.bluetooth.BluetoothGattDescriptor;
import android.bluetooth.BluetoothGattService;
import android.bluetooth.BluetoothManager;
import android.bluetooth.BluetoothProfile;
import android.bluetooth.le.BluetoothLeScanner;
import android.bluetooth.le.ScanCallback;
import android.bluetooth.le.ScanFilter;
import android.bluetooth.le.ScanResult;
import android.bluetooth.le.ScanSettings;
import android.content.Context;
import android.content.Intent;
import android.os.Binder;
import android.os.Build;
import android.os.IBinder;
import android.os.ParcelUuid;
import android.util.Log;

import java.nio.ByteOrder;
import java.text.SimpleDateFormat;
import java.util.ArrayList;
import java.util.Calendar;
import java.util.List;
import java.util.UUID;

/**
 * Service for managing the BLE data connection with the GATT database.
 */
@TargetApi(Build.VERSION_CODES.LOLLIPOP) // This is required to allow us to use the lollipop and later scan APIs
public class PSoCCapSenseLedService extends Service {
    private final static String TAG = PSoCCapSenseLedService.class.getSimpleName();

    // Bluetooth objects that we need to interact with
    private static BluetoothManager mBluetoothManager;
    private static BluetoothAdapter mBluetoothAdapter;
    private static BluetoothLeScanner mLEScanner;
    private static BluetoothDevice mLeDevice;
    private static BluetoothGatt mBluetoothGatt;

    // Bluetooth characteristics that we need to read/write
    //private static BluetoothGattCharacteristic mLedCharacterisitc;
    //private static BluetoothGattCharacteristic mCapsenseCharacteristic;
    private static BluetoothGattCharacteristic mTimeCharacterisitc;
    private static BluetoothGattCharacteristic mFilterGainCharacterisitc;
    private static BluetoothGattCharacteristic mRotationSpeedCharacterisitc;
    private static BluetoothGattCharacteristic mDrawTimeCharacterisitc;
    private static BluetoothGattCharacteristic mDrawOffsetCharacterisitc;
    private static BluetoothGattCharacteristic mVoltageCharacterisitc;

    private static int mTime;
    private static double mRotationSpeed = 0;
    private static int mDrawTime = 0;
    private static int mVoltage = 0;

    // UUIDs for the service and characteristics that the custom CapSenseLED service uses
    //private final static String baseUUID =                   "149F44D4-3340-4673-BE98-4F25C7DB6764";
    //private final static String capsenseLedServiceUUID =      baseUUID + "0";
    //public  final static String ledCharacteristicUUID =       baseUUID + "1";
    //public  final static String capsenseCharacteristicUUID =  baseUUID + "2";
    //private final static String CccdUUID =                   "00002902-0000-1000-8000-00805f9b34fb";

    private final static String povDisplayUUID              =  "149f44d4-3340-4673-be98-4f25c7db6764";
    private final static String timeUUID                    =  "1a270049-8bd1-49b7-82e3-82e287f555ed";
    private final static String filterGainUUID              =  "abb58d11-107a-448f-a448-0bbb2da7a917";
    private final static String rotationSpeedUUID           =  "0e7aaae4-d9b8-4410-859f-e98da0eb7d25";
    private final static String drawTimeUUID                =  "00953ce7-afc0-415d-82a5-a883fc562f6a";
    private final static String drawOffsetUUID              =  "e10f502d-1a04-4ff2-93d6-c50d60f96eed";
    private final static String voltageUUID                 =  "05192317-f383-4cf8-99ef-41400f603f4a";

    private final static String CccdUUID            =  "00002902-0000-1000-8000-00805f9b34fb";
    private static int CccdCounter = 0;

     // Variables to keep track of the LED switch state and CapSense Value
    private static boolean mLedSwitchState = false;
    private static String mCapSenseValue = "-1"; // This is the No Touch value (0xFFFF)

    // Actions used during broadcasts to the main activity
    public final static String ACTION_BLESCAN_CALLBACK =
            "com.cypress.academy.ble101.ACTION_BLESCAN_CALLBACK";
    public final static String ACTION_CONNECTED =
            "com.cypress.academy.ble101.ACTION_CONNECTED";
    public final static String ACTION_DISCONNECTED =
            "com.cypress.academy.ble101.ACTION_DISCONNECTED";
    public final static String ACTION_SERVICES_DISCOVERED =
            "com.cypress.academy.ble101.ACTION_SERVICES_DISCOVERED";
    public final static String ACTION_DATA_RECEIVED =
            "com.cypress.academy.ble101.ACTION_DATA_RECEIVED";

    public PSoCCapSenseLedService() {
    }

    /**
     * This is a binder for the PSoCCapSenseLedService
     */
    public class LocalBinder extends Binder {
        PSoCCapSenseLedService getService() {
            return PSoCCapSenseLedService.this;
        }
    }

    @Override
    public IBinder onBind(Intent intent) {
        return mBinder;
    }

    @Override
    public boolean onUnbind(Intent intent) {
        // The BLE close method is called when we unbind the service to free up the resources.
        close();
        return super.onUnbind(intent);
    }

    private final IBinder mBinder = new LocalBinder();

    /**
     * Initializes a reference to the local Bluetooth adapter.
     *
     * @return Return true if the initialization is successful.
     */
    public boolean initialize() {
        // For API level 18 and above, get a reference to BluetoothAdapter through
        // BluetoothManager.
        if (mBluetoothManager == null) {
            mBluetoothManager = (BluetoothManager) getSystemService(Context.BLUETOOTH_SERVICE);
            if (mBluetoothManager == null) {
                Log.e(TAG, "Unable to initialize BluetoothManager.");
                return false;
            }
        }

        mBluetoothAdapter = mBluetoothManager.getAdapter();
        if (mBluetoothAdapter == null) {
            Log.e(TAG, "Unable to obtain a BluetoothAdapter.");
            return false;
        }

        return true;
    }

    /**
     * Scans for BLE devices that support the service we are looking for
     */
    public void scan() {
        /* Scan for devices and look for the one with the service that we want */

        // Use old scan method for versions older than lollipop
        if (Build.VERSION.SDK_INT < Build.VERSION_CODES.LOLLIPOP) {
            //noinspection deprecation
        } else { // New BLE scanning introduced in LOLLIPOP
            ScanSettings settings;
            List<ScanFilter> filters;
            mLEScanner = mBluetoothAdapter.getBluetoothLeScanner();
            settings = new ScanSettings.Builder()
                    .setScanMode(ScanSettings.SCAN_MODE_LOW_LATENCY)
                    .build();
            filters = new ArrayList<>();
            // We will scan just for the CAR's UUID
            //ParcelUuid PUuid = new ParcelUuid(capsenseLedService);
            //ScanFilter filter = new ScanFilter.Builder().setServiceUuid(PUuid).build();
            ScanFilter filter = new ScanFilter.Builder().setDeviceName("POVDisplay").build();
            filters.add(filter);
            mLEScanner.startScan(filters, settings, mScanCallback);
        }
    }

    /**
     * Connects to the GATT server hosted on the Bluetooth LE device.
     *
     * @return Return true if the connection is initiated successfully. The connection result
     * is reported asynchronously through the
     * {@code BluetoothGattCallback#onConnectionStateChange(android.bluetooth.BluetoothGatt, int, int)}
     * callback.
     */
    public boolean connect() {
        if (mBluetoothAdapter == null) {
            Log.w(TAG, "BluetoothAdapter not initialized");
            return false;
        }

        // Previously connected device.  Try to reconnect.
        if (mBluetoothGatt != null) {
            Log.d(TAG, "Trying to use an existing mBluetoothGatt for connection.");
            return mBluetoothGatt.connect();
        }

        // We want to directly connect to the device, so we are setting the autoConnect
        // parameter to false.
        mBluetoothGatt = mLeDevice.connectGatt(this, false, mGattCallback);
        Log.d(TAG, "Trying to create a new connection.");
        return true;
    }

    /**
     * Runs service discovery on the connected device.
     */
    public void discoverServices() {
        if (mBluetoothAdapter == null || mBluetoothGatt == null) {
            Log.w(TAG, "BluetoothAdapter not initialized");
            return;
        }
        mBluetoothGatt.discoverServices();
    }

    /**
     * Disconnects an existing connection or cancel a pending connection. The disconnection result
     * is reported asynchronously through the
     * {@code BluetoothGattCallback#onConnectionStateChange(android.bluetooth.BluetoothGatt, int, int)}
     * callback.
     */
    public void disconnect() {
        if (mBluetoothAdapter == null || mBluetoothGatt == null) {
            Log.w(TAG, "BluetoothAdapter not initialized");
            return;
        }
        mBluetoothGatt.disconnect();
    }

    /**
     * After using a given BLE device, the app must call this method to ensure resources are
     * released properly.
     */
    public void close() {
        if (mBluetoothGatt == null) {
            return;
        }
        mBluetoothGatt.close();
        mBluetoothGatt = null;
    }

    /**
     * This method is used to read the state of the LED from the device
     */
     public void readAllCharacteristic() {
        if (mBluetoothAdapter == null || mBluetoothGatt == null) {
            Log.w(TAG, "BluetoothAdapter not initialized");
            return;
        }
        mBluetoothGatt.readCharacteristic(mRotationSpeedCharacterisitc);
     }

     public void syncTime() {
        // Get the current time and write the characteristic
         long now = System.currentTimeMillis();
         now /= 1000;
         // This is an ugly hack to get time into CDT
         now -= 5 * 3600;
         byte[] timeVal = new byte[4];
         timeVal[0] = (byte)((now >> 24) & 0xFF);
         timeVal[1] = (byte)((now >> 16) & 0xFF);
         timeVal[2] = (byte)((now >>  8) & 0xFF);
         timeVal[3] = (byte)((now      ) & 0xFF);
         mTimeCharacterisitc.setValue(timeVal);
         mBluetoothGatt.writeCharacteristic(mTimeCharacterisitc);
     }

     public void writeDisplayOffset(int offset)
     {
         byte [] offsetBytes = new byte[2];
         offsetBytes[0] = (byte)((offset >> 8) & 0xFF);
         offsetBytes[1] = (byte)((offset     ) & 0xFF);
         mDrawOffsetCharacterisitc.setValue(offsetBytes);
         mBluetoothGatt.writeCharacteristic(mDrawOffsetCharacterisitc);
     }

    public void writeFilterGain(int gain)
    {
        byte [] gainBytes = new byte[4];
        gainBytes[0] = (byte)((gain >> 24) & 0xFF);
        gainBytes[1] = (byte)((gain >> 16) & 0xFF);
        gainBytes[2] = (byte)((gain >>  8) & 0xFF);
        gainBytes[3] = (byte)((gain      ) & 0xFF);
        mFilterGainCharacterisitc.setValue(gainBytes);
        mBluetoothGatt.writeCharacteristic(mFilterGainCharacterisitc);
    }

    /**
     * This method is used to turn the LED on or off
     *
     * @param value Turns the LED on (1) or off (0)
     */
    public void writeLedCharacteristic(boolean value) {
/*
        byte[] byteVal = new byte[1];
        if (value) {
            byteVal[0] = (byte) (1);
        } else {
            byteVal[0] = (byte) (0);
        }
        Log.i(TAG, "LED " + value);
        mLedSwitchState = value;
        mLedCharacterisitc.setValue(byteVal);
        mBluetoothGatt.writeCharacteristic(mLedCharacterisitc);
*/
    }

    /**
     * This method enables or disables notifications for the CapSense slider
     *
     * @param value Turns notifications on (1) or off (0)
     */
    public void writeNotification(BluetoothGattCharacteristic characteristic, boolean value) {
        // Set notifications locally in the CCCD

        mBluetoothGatt.setCharacteristicNotification(characteristic, value);
        byte[] byteVal = new byte[1];
        if (value) {
            byteVal[0] = 1;
        } else {
            byteVal[0] = 0;
        }
        // Write Notification value to the device
        Log.i(TAG, "CapSense Notification " + value);

        BluetoothGattDescriptor Cccd = characteristic.getDescriptor(UUID.fromString(CccdUUID));
        Cccd.setValue(byteVal);
        mBluetoothGatt.writeDescriptor(Cccd);
    }

    /**
     * This method returns the state of the LED switch
     *
     * @return the value of the LED swtich state
     */
    public boolean getLedSwitchState() {
        return mLedSwitchState;
    }

    /**
     * This method returns the value of th CapSense Slider
     *
     * @return the value of the CapSense Slider
     */
    public String getCapSenseValue() {
        return mCapSenseValue;
    }

    public double getRotationRate() {return mRotationSpeed;}
    public int getVoltage()         {return mVoltage;}
    public int getDrawTime()        {return mDrawTime;}

    /**
     * Implements the callback for when scanning for devices has found a device with
     * the service we are looking for.
     *
     * This is the callback for BLE scanning on versions prior to Lollipop
     */
    private BluetoothAdapter.LeScanCallback mLeScanCallback =
            new BluetoothAdapter.LeScanCallback() {
                @Override
                public void onLeScan(final BluetoothDevice device, int rssi, byte[] scanRecord) {
                    mLeDevice = device;
                    //noinspection deprecation
                    mBluetoothAdapter.stopLeScan(mLeScanCallback); // Stop scanning after the first device is found
                    broadcastUpdate(ACTION_BLESCAN_CALLBACK); // Tell the main activity that a device has been found
                }
            };

    /**
     * Implements the callback for when scanning for devices has faound a device with
     * the service we are looking for.
     *
     * This is the callback for BLE scanning for LOLLIPOP and later
     */
    private final ScanCallback mScanCallback = new ScanCallback() {
        @Override
        public void onScanResult(int callbackType, ScanResult result) {
            mLeDevice = result.getDevice();
            mLEScanner.stopScan(mScanCallback); // Stop scanning after the first device is found
            broadcastUpdate(ACTION_BLESCAN_CALLBACK); // Tell the main activity that a device has been found
        }
    };


    /**
     * Implements callback methods for GATT events that the app cares about.  For example,
     * connection change and services discovered.
     */
    private final BluetoothGattCallback mGattCallback = new BluetoothGattCallback() {
        @Override
        public void onConnectionStateChange(BluetoothGatt gatt, int status, int newState) {
            if (newState == BluetoothProfile.STATE_CONNECTED) {
                broadcastUpdate(ACTION_CONNECTED);
                Log.i(TAG, "Connected to GATT server.");
            } else if (newState == BluetoothProfile.STATE_DISCONNECTED) {
                Log.i(TAG, "Disconnected from GATT server.");
                broadcastUpdate(ACTION_DISCONNECTED);
            }
        }

        /**
         * This is called when a service discovery has completed.
         *
         * It gets the characteristics we are interested in and then
         * broadcasts an update to the main activity.
         *
         * @param gatt The GATT database object
         * @param status Status of whether the write was successful.
         */
        @Override
        public void onServicesDiscovered(BluetoothGatt gatt, int status) {
            // Get just the service that we are looking for
            BluetoothGattService mService = gatt.getService(UUID.fromString(povDisplayUUID));
            /* Get characteristics from our desired service */
            mTimeCharacterisitc             = mService.getCharacteristic(UUID.fromString(timeUUID));
            mFilterGainCharacterisitc       = mService.getCharacteristic(UUID.fromString(filterGainUUID));
            mRotationSpeedCharacterisitc    = mService.getCharacteristic(UUID.fromString(rotationSpeedUUID));
            mDrawTimeCharacterisitc         = mService.getCharacteristic(UUID.fromString(drawTimeUUID));
            mDrawOffsetCharacterisitc       = mService.getCharacteristic(UUID.fromString(drawOffsetUUID));
            mVoltageCharacterisitc          = mService.getCharacteristic(UUID.fromString(voltageUUID));

            //mLedCharacterisitc = mService.getCharacteristic(UUID.fromString(ledCharacteristicUUID));
            //mCapsenseCharacteristic = mService.getCharacteristic(UUID.fromString(capsenseCharacteristicUUID));
            /* Get the CapSense CCCD */
            //mCapSenseCccd = mCapsenseCharacteristic.getDescriptor(UUID.fromString(CccdUUID));
            //mRotationCccd = mRotationSpeedCharacterisitc.getDescriptor(UUID.fromString(rotationCccdUUID));

            syncTime();

            // Read the current state of the LED from the device
            //readAllCharacteristic();


            // Broadcast that service/characteristic/descriptor discovery is done
            broadcastUpdate(ACTION_SERVICES_DISCOVERED);
        }

        /**
         * This is called when a read completes
         *
         * @param gatt the GATT database object
         * @param characteristic the GATT characteristic that was read
         * @param status the status of the transaction
         */
        @Override
        public void onCharacteristicRead(BluetoothGatt gatt,
                                         BluetoothGattCharacteristic characteristic,
                                         int status) {

            if (status == BluetoothGatt.GATT_SUCCESS) {
                // Verify that the read was the LED state
                String uuid = characteristic.getUuid().toString();
                // In this case, the only read the app does is the LED state.
                // If the application had additional characteristics to read we could
                // use a switch statement here to operate on each one separately.
                if(uuid.equals(rotationSpeedUUID)) {
                    final byte[] data = characteristic.getValue();
                    // Set the LED switch state variable based on the characteristic value ttat was read
                    int temp = java.nio.ByteBuffer.wrap(data).order(ByteOrder.LITTLE_ENDIAN).getInt();
                    mRotationSpeed = temp;
                    mRotationSpeed /= 100000;
                    mRotationSpeed = 1/mRotationSpeed;
                    mBluetoothGatt.readCharacteristic(mDrawTimeCharacterisitc);
                }

                if (uuid.equals(drawTimeUUID)) {
                    final byte[] data = characteristic.getValue();
                    mDrawTime = java.nio.ByteBuffer.wrap(data).order(ByteOrder.LITTLE_ENDIAN).getInt();
                    mBluetoothGatt.readCharacteristic(mVoltageCharacterisitc);
                }

                if (uuid.equals(voltageUUID)) {
                    final byte[] data = characteristic.getValue();
                    mVoltage = java.nio.ByteBuffer.wrap(data).order(ByteOrder.LITTLE_ENDIAN).getShort();
                }
                // Notify the main activity that new data is available
                broadcastUpdate(ACTION_DATA_RECEIVED);
            }
        }

        /**
         * This is called when a write completes
         *
         * @param gatt the GATT database object
         * @param characteristic the GATT characteristic that was read
         * @param status the status of the transaction
         */
        @Override
        public void onCharacteristicWrite(BluetoothGatt gatt,
                                         BluetoothGattCharacteristic characteristic,
                                         int status) {

            if (status == BluetoothGatt.GATT_SUCCESS) {
                // Verify that the read was the LED state
                String uuid = characteristic.getUuid().toString();
                if(uuid.equals(timeUUID)) {
                    CccdCounter++;
                    writeNotification(mRotationSpeedCharacterisitc, true);
                }
            }
        }

        /**
         * This is called when a write completes
         *
         * @param gatt the GATT database object
         * @param descriptor the GATT characteristic that was read
         * @param status the status of the transaction
         */
        @Override
        public void onDescriptorWrite(BluetoothGatt gatt,
                                          BluetoothGattDescriptor descriptor,
                                          int status) {

            if (status == BluetoothGatt.GATT_SUCCESS) {
                String uuid = descriptor.getUuid().toString();
                if(CccdCounter == 1) {
                    CccdCounter++;
                    writeNotification(mDrawTimeCharacterisitc, true);
                }
                else if(CccdCounter == 2) {
                    CccdCounter++;
                    writeNotification(mVoltageCharacterisitc, true);
                }

            }
        }


        /**
         * This is called when a characteristic with notify set changes.
         * It broadcasts an update to the main activity with the changed data.
         *
         * @param gatt The GATT database object
         * @param characteristic The characteristic that was changed
         */
        @Override
        public void onCharacteristicChanged(BluetoothGatt gatt,
                                            BluetoothGattCharacteristic characteristic) {

            String uuid = characteristic.getUuid().toString();

            // In this case, the only read the app does is the LED state.
            // If the application had additional characteristics to read we could
            // use a switch statement here to operate on each one separately.
            if(uuid.equals(rotationSpeedUUID)) {
                final byte[] data = characteristic.getValue();
                // Set the LED switch state variable based on the characteristic value ttat was read
                int temp = java.nio.ByteBuffer.wrap(data).order(ByteOrder.LITTLE_ENDIAN).getInt();
                float tempf = temp;
                tempf /= 1e6;
                mRotationSpeed = 1/tempf;
                //mBluetoothGatt.readCharacteristic(mDrawTimeCharacterisitc);
            }

            if (uuid.equals(drawTimeUUID)) {
                final byte[] data = characteristic.getValue();
                mDrawTime = java.nio.ByteBuffer.wrap(data).order(ByteOrder.LITTLE_ENDIAN).getInt();
                //mBluetoothGatt.readCharacteristic(mVoltageCharacterisitc);
            }

            if (uuid.equals(voltageUUID)) {
                final byte[] data = characteristic.getValue();
                mVoltage = java.nio.ByteBuffer.wrap(data).order(ByteOrder.LITTLE_ENDIAN).getShort();

            }

            // Notify the main activity that new data is available
            broadcastUpdate(ACTION_DATA_RECEIVED);
        }
    }; // End of GATT event callback methods

    /**
     * Sends a broadcast to the listener in the main activity.
     *
     * @param action The type of action that occurred.
     */
    private void broadcastUpdate(final String action) {
        final Intent intent = new Intent(action);
        sendBroadcast(intent);
    }

}
