nlbutts/POVDisplay/POVRotate.cydsn/types.h

/**
 * Copyright (c) 2016 Blackbird Engineering, LLC.
 * West Fargo ND, 58078
 * All rights reserved.
 *
 * File: types.h
 * Creator: Nick Butts
 * Date: Dec 28, 2016
 *
 * Copyright Version 1.0
 */

#ifndef TYPES_H
#define TYPES_H


#include <stdint.h>

#define false   0
#define true    ~false
    
typedef uint8_t bool; 


#endif /* TYPES_H */
