nlbutts/POVDisplay/(commit log)

2016-06-01 Copied in the USB drivers, and the HAL stuff.
2016-06-04 Code runs, but LED seems to be backwards and the fan signal doesn't seem to work.
    [main.c]
2016-09-26 Updated to the new POV Display project style.
    [POVBaseController.csv, POVBaseController.kicad_pcb, POVBaseController.sch]
2016-09-27 Updated the design and layout with an LDO.
    [POVBaseController.csv, POVBaseController.kicad_pcb, POVBaseController.sch]
2016-09-29 Updated design to use an ST switcher.
    [POVBaseController.sch]
2016-09-29 Completed the routing of the POVBaseController.
    [POVBaseController.csv, POVBaseController.kicad_pcb, POVBaseController.sch]
2016-09-29 Ordering the POVBaseController
    [POVBaseController.kicad_pcb, POVBaseController.sch]
2016-10-04 Minor updates.
    [POVBaseController.csv, POVBaseController.kicad_pcb]
2016-10-27 Added the POVRate HW
    [BLE.sch, LEDs.sch, POVBaseController.sch, POVRotateHW.kicad_pcb, POVRotateHW.sch, Power.sch]
2016-10-27 Started working on the schematic for the POV Rotate board.
    [BLE.sch, Power.sch]
2016-10-31 Connected some pins up.
    [BLE.sch, LEDs.sch]
2016-10-31 Finished the schematic for the POVRotate system, started on layout.
    [BLE.sch, LEDs.sch, POVRotateHW.csv, Power.sch]
2016-11-01 Started work on the POV Rotate layout.
    [BLE.sch, LEDs.sch, POVRotateHW.kicad_pcb, Power.sch]
2016-11-02 Moved parts around.
    [POVRotateHW.kicad_pcb, Power.sch]
2016-11-03 Working on PCB placement.
    [POVRotateHW.kicad_pcb]
2016-11-03 Updated the designs ref des to the LEDs work.
    [LEDs.sch, POVRotateHW.kicad_pcb]
2016-11-04 Finished routing board. Need to do another once over.
    [POVRotateHW.kicad_pcb]
2016-11-05 Updated the 3D shapes. Debating if I should try and squish the design into a smaller form factor.
    [POVRotateHW.kicad_pcb]
2016-11-09 Added silk screen.
    [POVRotateHW.kicad_pcb]
2016-12-01 Minor updates based on the actual PCB.
    [BLE.sch, LEDs.sch, POVRotateHW.csv, POVRotateHW.sch, Power.sch]
2016-12-02 Rerouting board for RevB
    [BLE.sch, LEDs.sch, POVRotateHW.kicad_pcb]
2016-12-05 Added the EEPROM library and issues.txt
    [EEProm.c, EEProm.h, main.c]
2016-12-07 Switched the LED driver to a 24-bit LED driver from ST.
    [BLE.sch, LEDs.sch, POVRotateHW.csv]
2016-12-07 Starting layout on the new design.
    [LEDs.sch, POVRotateHW.kicad_pcb, Power.sch]
2016-12-07 Worked on routing the LEDs.
    [LEDs.sch, POVRotateHW.kicad_pcb, Power.sch]
2016-12-08 The routing is almost complete.
    [POVRotateHW.kicad_pcb]
2016-12-08 Finished the routing.
    [POVRotateHW.kicad_pcb]
2016-12-09 Completed layout and updates to silk screen.
    [BLE.sch, LEDs.sch, POVRotateHW.csv, POVRotateHW.kicad_pcb]
2016-12-09 Order the boards.
    [POVRotateHW.kicad_pcb]
2016-12-11 Added a 3D drawing. Added a POVBase with an HBridge.
    [POVBaseHBridge.sdf, motorMount.stl, motorMount.stp, motor_adapter.FCStd]
2016-12-14 Updated the mechanical mount.
    [motorMount.stl, motor_adapter.FCStd]
2016-12-20 Added the PCB Motor mount. Removed the STL files.
    [PCBMotorMount.FCStd, motorMount.stl]
2016-12-20 Updated mechanical components.
    [PCBMotorMount.FCStd]
2016-12-28 Updated schematic and removed some old datasheets.
    [BLE.sch]
2016-12-28 Added additional datasheets and LED code.
2016-12-31 Updates. Everything (except the EEPROM) is now working.
    [POVBaseHBridge.sdf]
2016-12-31 Added the EEPROM library and the UART_TO_BLE_Peripherial.
    [UART_to_BLE_peripheral.sdf]
2016-12-31 Added the BLE code to create a UART interface
2016-12-31 Updated the gitignore file and added the datasheet for the LEDs.
2017-01-03 More updates. I have a sydstem that now displays a one second time as well as a crazy pattern.
    [BLE.sch, LEDs.sch, POVBaseController.sch, POVRotateHW.sch, Power.sch]
2017-01-04 Updated the mechanical components.
    [PCBMotorMount.FCStd, motor_adapter.FCStd]
2017-01-05 Started to work on the POV Base Controller.
    [POVBaseController.sch, motor_adapter.FCStd]
2017-01-06 Updated the POVBaseController schematic. Adding the DRV8848.
    [POVBaseController.sch]
2017-01-06 More work on the new base controller.
    [POVBaseController.sch, motor_adapter.FCStd]
2017-01-07 Finished the POV H-Bridge controller schematic and working on layout.
    [POVBaseController.csv, POVBaseController.kicad_pcb, POVBaseController.sch]
2017-01-08 Finished the layout of the POV Base Controller.
    [POVBaseController.kicad_pcb, POVBaseController.sch]
2017-01-08 Added the start of the new base coil.
    [POVBaseCoil.kicad_pcb, POVBaseCoil.sch]
2017-01-08 Totally refactored the POV Base Controller.
    [POVBaseController.kicad_pcb, POVBaseController.sch]
2017-01-09 Completed the POV Base coil.
    [POVBaseCoil.kicad_pcb, POVBaseCoil.sch]
2017-01-09 Updated the motor mount. I got it wrong... again.
    [motor_adapter.FCStd]
2017-01-23 Ordered the POV Base Controller and the POV Base Coil.
    [POVBaseController.kicad_pcb, POVBaseController.sch]
2017-01-31 Updated the designs with better cutouts and 3D parts.
    [PCBMotorMount.FCStd, POVBaseCoil.kicad_pcb, POVBaseController.kicad_pcb]
2017-01-31 Started work on a combined mechanical part.
    [POVDisplay.FCStd]
2017-02-01 Updated the main mechanical layout
    [POVDisplay.FCStd]
2017-02-07 Started implementing RTC for the POV Display. Tried using DesignSpark MEchanical to design mounts.
    [POVBaseController.kicad_pcb, motor_adapter.FCStd]
2017-02-20 Tried to update the mechanical components.
    [TopMotorMount.FCStd]
2017-03-05 Created a main mount for the new Base boards.
    [PCBMotorMount.FCStd, PCBMount.FCStd, POVBaseDriver.FCStd, TopMotorMount.FCStd, motorMount.stp, motor_adapter.FCStd]
2017-03-23 Added date display, updated mechanical designs.
    [PCBMotorMount.FCStd, UART_to_BLE_peripheral.sdf, motor_adapter.FCStd]
2017-03-23 Added a device to balance the wobble.
    [BalanceSlider.FCStd, BalanceWeight.FCStd]
2017-03-26 Added additional code for BLE. Can set time, see speed, change filter coeff.
    [POVBaseDriver.FCStd]
2017-03-29 Checked in app
    [POVBaseDriver.FCStd]
2018-04-07 Made some changes to the code to display a clock. Started to refactor the main mount.
    [PCBMotorMount.FCStd]
2018-04-08 Design is working and I can correctly offset the time.
    [PCBMotorMount.FCStd]
2018-04-08 Added mounts that will be used to bolt the unit down to wood.
    [WoodMounts.FCStd]
2018-04-08 Got gitfucked again. Had to manually fix files.
    [EEProm.c, main.c]
