nlbutts/POVDisplay/(notices)

Notices in the files:
POVBaseController/POVBaseController.kicad_pcb:
Copyright 2017
POVRotateHW/POVRotateHW.kicad_pcb:
Copyright 2016
